ut-robotics/picr22-team-saga/(threads)

Thread 1 (2022-09-19):

[Mechanics] Bring thrower motor lower

maidlam, 2022-09-19:
The thrower motor is able to touch only a slight part of the ball.
Bringing the thrower motor lower by 2 mm (but not more), can improve grabbing ability.

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

Closed 2022-09-24.

Thread 2 (2022-09-19):

[Mechanics] Thrower ramp spacers

maidlam, 2022-09-19:
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

The holes for spacers at position 1 are very close to the planned mounting hole for the side wall.

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

The spacers at position 1 can be removed, and spacers at position 2 can be brought lower, maybe to the midway point between 1 and 2

Add a spacer to the front of the ramps at position 3 for better stability.

Closed 2022-09-24.

Thread 3 (2022-09-19):

[Mechanics] Check direction of thrower motor wires

maidlam, 2022-09-19:
In the current model, it seems like the thrower motor wires will come out into the ramp.
I think the wire hole is in the wrong position in the model.
Verify the actual location of the wires on your physical motor and add a box to represent the wires.

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

georgsnarbuts, 2022-09-21:
I compared this cad model to our actual motor and the wires seem to be located in the same place so i rotated the motor by 180 degrees, so the wires could point outwards. Is this good?

Closed 2022-09-24.

Thread 5 (2022-09-19):

[Mechanics] Move thrower assembly further back

maidlam, 2022-09-19:
Your test robot has a wide front. At the same time the motor is the most forward component in the robot. This can lead to horrible accuracy. The ball can go through the thrower in this motion if it's grabbed from the side.

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

One option to fix this is to move the ramp and thrower motor further back into the robot.
This will give room for the ball to be guided and be centered.
There's some room left behind the thrower, giving the option to do so.

Closed 2022-09-24.

Thread 6 (2022-09-19):

[Mechanics] Make wall mounting holes threaded

maidlam, 2022-09-19:
Currently the mounting holes for the walls are 3 mm unthreaded holes.

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

These should be made as threaded holes. Use the Hole feature to make these.
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

Closed 2022-09-24.

Thread 7 (2022-09-24):

[Mechanics] Thrower assembly too wide

Akustav, 2022-09-24:
The thrower assembly is 0.4mm too wide and tabs clip into the bottom plate:

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

maidlam, 2022-09-30:
Current distance between thrower walls is 50,40 mm.
The top and bottom plate have different distances for the holes for the walls.

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

The holes in the top plate are sketched separately, while the bottom plate uses a pattern to make the holes, that's where the offset might be coming from.

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

Don't know if the holes on the actual robot might have been modified, or the thrower was just jammed in.

Akustav, 2022-10-01:
I think we had one robot that had alignment issues due to a oversight in the review. I think it was milled out like that. I think we modified the thrower tabs to accommodate the thrower. Seems like a small issue, overall.

Closed 2022-10-01.

Thread 8 (2022-09-24):

[Mechanics] motor mount hole joining issue

Akustav, 2022-09-24:
Seems like the motor is joined in a 90 degree offset to how it should be:

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

Closed 2022-09-30.

Thread 10 (2022-10-01):

CM1223 footprint incorrect

ReikoR, 2022-10-01:
SOT143-4 footprint is used:

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

Correct CM1223-**02SO** package is SOT23−5:

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

This is also mentioned on [Components page](https://ut-robotics.github.io/picr22-home/basketball_robot_guide/electronics/components.html#_usb_protection).

AnishShr, 2022-10-03:
Changed the footprint with correct one.

Closed 2022-10-04.

Thread 11 (2022-10-01):

NCP164CSN330T1G does not need feedback resistors

ReikoR, 2022-10-01:
NCP164CSN330T1G has fixed output of 3.3V (V<sub>FIX</sub>).

Feedback resistors can technically be used, but would probably not work if reference voltage is the same or higher compared to output voltage.

From [datasheet](https://www.onsemi.com/pdf/datasheet/ncp164-d.pdf):
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

Closed 2022-10-04.

Thread 12 (2022-10-01):

NCP164 enable pin needs to be connected

ReikoR, 2022-10-01:
I think NCP164 has weak pull-down on enable (EN) pin that disables the regulator when enable pin is left unconnected:

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

Enable pin can be connected to IN pin to enable the regulator.

AnishShr, 2022-10-10:
connected the EN pin to IN.

Closed 2022-10-11.

Thread 13 (2022-10-01):

NCV8730ASN500T1G does not need feedback resistors

ReikoR, 2022-10-01:
NCV8730ASN500T1G has fixed output of 5V.

From [datasheet](https://www.onsemi.com/pdf/datasheet/ncv8730-d.pdf):
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

AnishShr, 2022-10-03:
Feedback resistors removed.

Closed 2022-10-04.

Thread 15 (2022-10-01):

Incorrect encoder connector pinout

ReikoR, 2022-10-01:
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

All existing encoders use this pinout:

1. GND
2. 3.3V
3. ENCA
4. ENCB

Power needs to be connected. Right now it has not been connected.

GND needs to be connected to MCU side. Right now it's connected to motor drivers side (GND2).
Encoders and motors are not electrically connected, only mechanically

AnishShr, 2022-10-03:
Conenctor with correct wire orientation updated.

ReikoR, 2022-10-04:
Avoid placing GND symbols pointing up.
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

GND should point down and positive power symbols should point up. It would be nicer to use power symbols for them not the net labels.
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

Encoder connectors are still connected to GND2. Encoders need to be connected to MCU GND.

AnishShr, 2022-10-10:
changed the symbol orientations accordingly.

Closed 2022-10-11.

Thread 16 (2022-10-01):

Incorrect thrower ESC signal connector pinout

ReikoR, 2022-10-01:
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

Current ESC connectors have this pinout:

1. GND
2. PWM
3. Not connected
4. Not connected

AnishShr, 2022-10-03:
Connector with correct wire orientation updated.

Thread 17 (2022-10-01):

nFAULT LEDs not connected correctly

ReikoR, 2022-10-01:
DRV8243 nFAULT pins are open drain outputs.

For LEDs to work, they need be connected to logic voltage (5V in this case).

More information:
https://ut-robotics.github.io/picr22-home/basketball_robot_guide/electronics/schematic.html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

AnishShr, 2022-10-03:
LEDs removed from the nFAULT lines.

ReikoR, 2022-10-04:
LEDs can still be used, but have to be connected differently.

Closed 2022-10-04.

Thread 18 (2022-10-01):

PDRV8243HRXYQ1 does not have SPI

ReikoR, 2022-10-01:
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

DRV8243 drivers we have are the HW variant in VQFN-HR (14) package.

AnishShr, 2022-10-03:
Symbol and footprint with VQFN-HR(14) variant updated

ReikoR, 2022-10-04:
All configuration pins cannot be left unconnected.
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

**IPROPI** pin needs a resistor to set the output current limit. I recommend configuring current limit to around 2 - 3A to help prevent motor from overheating.
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

**DRVOFF** need to be connected to ground, otherwise the outputs will be disabled. DRVOFF has internal pullup.
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

**DIAG** pin I would recommend connecting to GND to allow the driver to enable the outputs again after a small off period (t<sub>off</sub>). This allows for higher motor power, but it might be ok without it also.
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

**MODE** pin needs to be connected to set the driver to PH/EN (PWM/direction) mode.
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

I added older datasheet that contains pre-production driver information to the components page:
https://ut-robotics.github.io/picr22-home/basketball_robot_guide/electronics/components.html#_motor_driver

AnishShr, 2022-10-06:
According to the datasheet:
For the VQFN-HR package, AIPROPI = 3070 A/A
We are operating the HW variant in RLVL6of6 for ITRIP, SR, and DIAG, meaning not connecting those pins.
For this config, VITRIP = 2.97 V
For this configuration:
ITRIP Regulation = VITRIP / RITRIP * AIPROPI
This yields RITRIP approximately to 3040 Ohms. What will be the closest resistance we have in the 0603 package to this resistance?

ReikoR, 2022-10-08:
You might have already checked yourself, but in the lab we have 3k and also 2.7k and 3.3k 0603 resistors.

AnishShr, 2022-10-10:
Connected all other pins as instructed in the datasheet.

Closed 2022-10-11.

Thread 19 (2022-10-01):

DRV8243 VM pins need more capacitance

ReikoR, 2022-10-01:
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

More capacitance is needed during switching at driver's input (VM) to avoid voltage drop at the driver's output.
Around 50 uF or more might be fine. For example it's possible to use 5x 10 uF ceramic capacitors.

AnishShr, 2022-10-03:
50uF capacitance put across the driver's output

ReikoR, 2022-10-04:
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

50uF 0603 capacitors do not exist.

For example 47uF 25V capacitors are much bigger and expensive:
https://www.mouser.ee/c/passive-components/capacitors/mlccs/multilayer-ceramic-capacitors-mlcc-smd-smt/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

Using 5x 10 uF 1206 25V+ capacitors or similar is better option.

Typical recommendation is to use capacitors with voltage rating at least twice the maximum working voltage. For 16.8V batteries it the closest voltage rating is 35V, but 25V should also be ok in this case. Ceramic capacitor capacitance decreases with voltage.

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
https://www.murata.com/en-us/support/faqs/capacitor/ceramiccapacitor/char/0005

AnishShr, 2022-10-10:
changed the 50uF capacitor with a parallel combination of 5 10uF capacitors (5 X10uF = 50uF)

ReikoR, 2022-10-11:
10uF capacitance is bit too big for 0603 capacitors. 0603 10uF capacitors are not that common and cost more. In the lab we have 1206 capacitors. We can also order 0805 capacitors which cost about the same as 1206 ones.

You should change 10uF capacitors to either 1206 or 0805 package.

AnishShr, 2022-10-11:
changed the 10uF capacitors to 0805 package

Closed 2022-10-12.

Thread 20 (2022-10-01):

Keep isolated sides completely separate

ReikoR, 2022-10-01:
There needs to be clear separation between isolated sides, that splits the board in two.

Illustrative image with some modifications. Taken from [this guide](https://www.ti.com/lit/an/slla284f/slla284f.pdf?ts=1664620687565):

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

ReikoR, 2022-10-03:
Yes, there should not be any copper.

AnishShr, 2022-10-10:
Isolator's sides to be isolated are completely isolated (Not even copper pour in between)

ReikoR, 2022-10-11:
Grounds should not extend past the isolators.

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

AnishShr, 2022-10-11:
GND and GND2 filled on both inner layers with ground not extending past the isolators

Closed 2022-10-12.

Thread 22 (2022-10-01):

Mounting holes are too close to the edge

ReikoR, 2022-10-01:
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

AnishShr, 2022-10-03:
Mounting holes shifted a little inside.

ReikoR, 2022-10-05:
Holes are still probably too close to the edges:
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

Also Typical M3 bolt head has a diameter of about 5.5mm. There should not be any tracks or components near the mounting holes that might be damaged by the bolt head:
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

AnishShr, 2022-10-10:
Mounting hole's external diameter is set to 6mm, and the hole to 3mm.

Closed 2022-10-11.

Thread 23 (2022-10-01):

Add reverse voltage protection MOSFET to motor drivers power input

ReikoR, 2022-10-01:
More info:
https://ut-robotics.github.io/picr22-home/basketball_robot_guide/electronics/components.html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

ReikoR, 2022-10-04:
Yes, they are connected.

AnishShr, 2022-10-10:
Added the reverse voltage protection MOSFET to Motor driver's input pin.

ReikoR, 2022-10-11:
1. There is no need for multiple MOSFETs, 1 is enough.
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

2. I don't think that 1N53xxB diodes exist in 0603 package. You need to select a diode that we have in the lab (not sure if and what we have) or that can be ordered. For BUK6Y10 you probably won't need the diode, because the gate-source voltage rating is 20V, which is higher than the battery voltage.
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

3. You definitely should not have 10-ohm resistor across battery voltage.
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

In the [guide](https://components101.com/articles/design-guide-pmos-mosfet-for-reverse-voltage-polarity-protection) they are used a a load. For the mainboard the load is the motors.
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

AnishShr, 2022-10-11:
changed the connections as instructed with just one MOSFET

Closed 2022-10-12.

Thread 24 (2022-10-01):

Use as wide as possible connections for high currents

ReikoR, 2022-10-01:
Motor driver outputs and power supply should use wider connections.

Based on Saturn PCB Toolkit a 0.4 mm wide track can carry 2.3A at 20 degree temperature rise:

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

Motor drivers might output more current and power supply traces need to carry 3 times of that if drivers are connected in series.
I recommend having wide and short copper zones for high currents.

AnishShr, 2022-10-03:
Motor driver's output with track width 0.5mm updated.

ReikoR, 2022-10-05:
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

It would be better if connections were shorter and wider.
Current pin headers are not a very good choice for connecting motor outputs. It would be better to create component with a SMD pad footprint large enough to allow wires to be soldered to it.

For example something like this:
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

Small vias can be placed inside drivers pads for the shortest connections to power. Capacitors can be placed on the other side of the board below drivers.
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

AnishShr, 2022-10-10:
Track width for the motor driver's output lines have been set to the width of the motor driver's ouptut pad width.

AnishShr, 2022-10-11:
changed the connectors making the connections short

ReikoR, 2022-10-12:
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

High current connections need to be wider.

Use copper zones and multiple small vias (0.2/0.45mm is the recommended smallest size by JLCPCB).

Rough example:
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

Driver outputs and V+ should also be connected with wide copper fills.

AnishShr, 2022-10-13:
High current paths all connected with copper fills

ReikoR, 2022-10-15:
1. Use solid pad connection for high currents:
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

2. Use multiple small vias instead of one larger via. Multiple small vias have smaller total inductance, higher current carrying capability and don't pull away the solder that easily when placed inside a pad.
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

3. Drill diameter for small vias should be 0.2mm, otherwise the annual ring will be too narrow.
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

4. Use larger pads for high currents. Current pads might be too small to solder wires to. Larger pads also are more robust. Smaller pads might break off the board. Putting multiple vias inside the pad would also help to make it mechanically more robust.
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

AnishShr, 2022-10-20:
All power lines routed through copper fills

ReikoR, 2022-10-23:
1. Reverse voltage protection MOSFET could be rotated to make VM polygon wider.
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
\
It would be even better if battery input (V+) pad could be placed on top of the MOSFET.
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

2. Motor driver VM capacitor could be better aligned with the driver pads.
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

3. There is no need to place vias inside pads for motor driver configuration pins. This will make soldering harder.
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
\
Something like this should be enough:
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

AnishShr, 2022-10-23:
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

How can we get rid of this issue? The copper fill clearance is set to 0.25 mm, but the fill has a clearance of 0.1016mm only in one of the edges.

ReikoR, 2022-10-23:
You should use different priority levels for adjacent zones. Then the zones are filled in an order and clearance between them is automatically kept.
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

AnishShr, 2022-10-23:
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
Is this warning fired because 'VM' is present in only one layer?

ReikoR, 2022-10-23:
Yes

AnishShr, 2022-10-23:
So shall I copper fill on the other layer as well? Or what shall I do?

ReikoR, 2022-10-23:
Just remove those vias, since they are not connecting to anything on other layers.

AnishShr, 2022-10-23:
These vias also include the ones in the decoupling capacitors. Should I remove them as well?

ReikoR, 2022-10-23:
If you mean the ones connected to MCU VDDA, then yes.

AnishShr, 2022-10-23:
unnecessary vias removed and power routed via copper fills and usage of multiple small vias where necessary

AnishShr, 2022-10-26:
Most part of the nSleep trace routed in front copper making wise copper fills for VM

ReikoR, 2022-10-26:
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

Rotating the reverse voltage protection MOSFET would help to improve current paths:
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

AnishShr, 2022-10-26:
MOSFET rotated and shifted to provide better current distribution path as instructed.

ReikoR, 2022-10-27:
MOSFET should not moved too much to the center of the board. Having signal traces close to each other will cause more noise on them.

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

AnishShr, 2022-10-27:
MOSFET moved away from other traces

ReikoR, 2022-10-29:
You should also route tracks straighter and with more spacing between them. Noise on a trace from an adjacent trace is bigger when tracer are closer to each other or are close for longer. Running traces parallel next to each other should be minimised.
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

AnishShr, 2022-10-30:
Spacing between traces increased

Closed 2022-10-31.

Thread 25 (2022-10-01):

Prefer 0603 passive components

ReikoR, 2022-10-01:
Most of the passive components available in the lab are in 0603 package.
If you don't want or need to save board space, then it would be better to use 0603 for most of the passive components.

AnishShr, 2022-10-03:
All passive component's footprint updated to 0603 package.

AnishShr, 2022-10-10:
All passive components changed to the 0603 package

AnishShr, 2022-10-11:
apart from 10uF capacitors, all other passive device changed to 0603 package

Closed 2022-10-12.

Thread 26 (2022-10-01):

Use switching regulator instead of linear regulator for servo power

ReikoR, 2022-10-01:
Linear regulators are too inefficient for higher currents.

We have these components available in the lab:

- XTPS62933DRLR (TPS62933 buck converter)
- SRP6060FA-5R6M (Inductor 5.6uH 10A)

You can use TI WEBENCH to get recommended designs for TI components:
https://webench.ti.com/power-designer/switching-regulator

ReikoR, 2022-10-05:
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
1. On the schematic you have TPS62932, not TPS62933.

2. Pinout is incorrect. Correct pinout from datasheet:
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

3. Power inductor needs to connected to SW pin, not a ferrite bead. We have SRP6060FA-5R6M inductors, which are suitable.
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

4. Switching regulator and all other components connected to the motors power should be on the other side of the isolators. PCB needs to be clearly divided into two isolated sides.
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

AnishShr, 2022-10-10:
The footprint for ferritebead changed to indcutor. And the isolators have been placed between two different power sources, dividing the PCB into two parts in regard to the power source.

ReikoR, 2022-10-11:
1. Bootstrap capacitor needs to be connected between BST and SW pins. SW pin needs to be connected to inductor.
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

2. Feedback resistors need to connect to FB pin.
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

AnishShr, 2022-10-11:
changed the connections for the BUK6Y10. Removed the diode and 10 ohm resistors, with feedback resistors connected to FB pin, and bootstrap capacitor between SW and BST pin

ReikoR, 2022-10-15:
1. Inductance is still incorrect.
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

2. Try to follow layout guidelines in the [TPS62933 datasheet](https://www.ti.com/lit/ds/symlink/tps62933.pdf).

For example:
> Place the inductor, input and output capacitors, and the IC on the same layer.

Currently regulator and inductor are on the top layer and capacitors on the bottom layer.
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

> Place the input and output capacitors as close as possible to the IC.

Output capacitor is far away.
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

> The VIN and GND traces must be as wide as possible and provide sufficient vias on them to minimize trace impedance. The wide areas are also of advantage from the view point of heat dissipation.
Keep the SW trace as physically short and wide as practical to minimize radiated emissions.

Current traces/connections are narrow and could probably be shorter. Use multiple small vias (0.2/0.45) for VIN, GND, +5VD for lower inductance. In general multiple smaller vias work better than one larger via for reducing inductance and having higher current carrying capability.

3. It would also be better to have servo connector near the regulator output.
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

4.  In regards of more general layout, having isolators on the top layer and switching regulator components on the bottom side might improve the layout. Right now every signals needs a via on both sides of the isolators.
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

AnishShr, 2022-10-20:
Inductor connection updated, with input/output capacitors placed close.

Also, the power lines are routed through copper fills, each pad with multiple small vias.

ReikoR, 2022-10-23:
1. Inductance value is still incorrect.
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

2. From [datasheet](https://www.ti.com/lit/ds/symlink/tps62933.pdf):
> Place the feedback divider as close as possible to the FB pin. A > 10-mil width trace is recommended for heat dissipation. Connect a separate VOUT trace to the upper feedback resistor. Place the voltage feedback loop away from the high-voltage switching trace. The voltage feedback loop preferably has ground shield.

It's better to have separate 5V feedback trace that is shielded with ground vias. Running it on opposite layer (top in this case) should help to shield it more.
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

3. All the vias marked with a yellow arrow do not connect to any other layers and should be removed:
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

4. There is only 1 ground via:
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
\
Something like this would be better:
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
I rotated and moved the capacitors a bit and added copper fill on bottom layer and multiple ground vias.

AnishShr, 2022-10-23:
8.8 uH Inductor placed with power routed through copper fills and use of vias

ReikoR, 2022-10-25:
1. SRP6060FA-5R6M is a 5.6uH inductor, not 6.8uH.
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

2. 5V feedback trace is quite close to driver signal traces.
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
\
It would be better to increase distance between traces and add ground vias for shielding:
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

3. 5V feedback should only be connected with trace on top layer and not with copper fill on bottom layer:
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

4.  FB trace is very close to the inductor.
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
\
Try to follow layout recommendations in the datasheet:
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
\
Something like this might be better:
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

AnishShr, 2022-10-26:
Changed the layout and added GND vias across one side of the 5V trace.

Closed 2022-10-26.

Thread 9 (2022-10-01):

Pull-up resistor on USB D+ line is not needed

ReikoR, 2022-10-01:
SMT32G441 has embedded pull-up resistor.

From [datasheet](https://www.st.com/resource/en/datasheet/stm32g441kb.pdf):
> **3.35 Universal serial bus (USB)**
> ... The internal USB PHY supports USB FS signaling, embedded DP pull-up and ...

More information is available under **45 Universal serial bus full-speed device interface (USB)** in [reference manual](https://www.st.com/resource/en/reference_manual/rm0440-stm32g4-series-advanced-armbased-32bit-mcus-stmicroelectronics.pdf).

AnishShr, 2022-10-03:
The pull up resistor has been removed. Pushed new design in the github repository: https://github.com/ut-robotics/picr22-team-saga/tree/electronics

Thread 27 (2022-10-05):

[Mechanics] Change Spacing in Arrange

maidlam, 2022-10-05:
Change the Spacing setting in the Arrange feature for the Manufacturing Model.
The 6 mm value in Object Spacing causes the tool to jump between parts to mill them out (6 mm gap, 3 mm wide tool, Fusion wants to keep the part attached to the stock material until the very end).
Use these settings below.

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

Closed 2022-10-06.

Thread 28 (2022-10-05):

[Mechanics] Move Pocket operation before Contours

maidlam, 2022-10-05:
After milling out a piece, depending on factors, there is a chance that the piece can move/ become loose, the pocket might not end up at the desired place.
See also: https://ut-robotics.github.io/picr22-home/basketball_robot_guide/mechanics/cam.html#_order_of_operation

Move the pocket operation above the Contours, so it will be done before the Contours.

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

Closed 2022-10-06.

Thread 29 (2022-10-05):

[Mechanics] Change Stock to Leave for Pocket

maidlam, 2022-10-05:
Change the Stock to Leave values of the Pocket operation.
Current settings don't cut the material at all.

Use the settings from the guide:
https://ut-robotics.github.io/picr22-home/basketball_robot_guide/mechanics/cam.html#_pocket

Closed 2022-10-06.

Thread 30 (2022-10-12):

Place ESD protection as close as possible to USB connector

ReikoR, 2022-10-12:
TVS diodes (diode arrays) should be placed as close as possible to connectors to prevent ESD from reaching to any of the components.

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

AnishShr, 2022-10-13:
ESD protection placed close to the USB

ReikoR, 2022-10-23:
ESD protection could be even closer, but it might be good enough.
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

Closed 2022-10-23.

Thread 31 (2022-10-12):

Fix DRC errors (and warnings if possible)

ReikoR, 2022-10-12:
Use **Inspect -> Design Rule Checker**

Unconnected nets are the probably the biggest problem:
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

Unconnected nets can also be seen without running DRC.
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

AnishShr, 2022-10-13:
DRC errors fixed, except few(Not an error actually)

Please have a look

ReikoR, 2022-10-15:
There is a clear unconned +3.3V net:
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

AnishShr, 2022-10-15:
The unconnected 3.3V nets both are connected to two 3.3V pins of the microcontroller, which are internally connected. Is it necessary to connect them externally?

ReikoR, 2022-10-16:
Power should never be routed through components. Component might not have enough current carrying capability and all the noises add together if current paths are shared between components. Ideally power should be routed from single point (power source) to each component through separate (straight) path.

It would probably be better to change bottom layer copper fill from GND to +3.3V and route most of the signals on top layer to reduce gaps in the +3.3V copper. There already are 2 GND copper fills on internal layers.

ReikoR, 2022-10-23:
There are still a lot of errors that can be fixed.

AnishShr, 2022-10-23:
DRC errors fixed (Few warnings left: especially for mounting holes vias)

Closed 2022-10-26.

Thread 32 (2022-10-15):

Improve USB signal routing

ReikoR, 2022-10-15:
Current routing:
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

1. USB data signals are a 90-ohm differential pair and should be routed on the PCB to match that.
2. Using vias should be avoided for differential pairs or if not possible, should be kept symmetric in both signals in a pair, so that same amount of vias is used and at the same locations in both signal traces.
3. Traces should also be as symmetric and straight as possible.
4. Differential signal routing should usually prioritised over routing other (single-ended) signals and power.

JLCPCB has [impedance calculator](https://cart.jlcpcb.com/impedanceCalculation) for their stackups.
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

We'll use JLC3313 stackup, because it has smaller gap between layers, which helps to improve signal integrity because electric fields (between signal and reference [usually GND] layer) of different signals interact less with each other, since electric fields don't spread out as much.

8 mil gap and 6.03 mil trace widths are close enough to 2mm and 1.5mm, so those can be used.

Differential pair (DP) width and gap can be specified in the Board Setup.
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

Some board constraints should also be adjusted.
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

Default shortcut for differential pair routing is 6.
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

AnishShr, 2022-10-16:
Should the differential pair be symmetric for connections to the ESD protection as well, or is it ok if the differential pair routing is symmetric only from the microcontroller pins to the SUB?

ReikoR, 2022-10-16:
Ideally differential pair should be symmetric everywhere. ESD protection should be aligned so that the signals can be routed underneath the ESD protection component.

Example layout of ESD protection component with same pinout as CM1223-02SO:
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

Image taken from here:
https://www.we-online.com/catalog/media/o109030v410%20AppNotes_ANP002_TheProtectionOfUSB20Applications_EN.pdf

AnishShr, 2022-10-20:
Differential pair routed

ReikoR, 2022-10-23:
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

USB differential signals can be more straight and symmetric.

KiCad differential pair routing does not work very well, so some manual routing and moving of tracks is probably needed.

Improved result can look something like this:
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

AnishShr, 2022-10-23:
Differential pair for USB routed appropriately (please check)

ReikoR, 2022-10-25:
1. USB signal traces do not have correct width:
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

2. I'm not sure if there are manufacturing issues with it, but it's probably good idea to avoid sharp (internal) corners:
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
\
Connect straight to pads if possible:
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
\
Or move traces slightly away from the pads:
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

AnishShr, 2022-10-26:
Traces palces straight to the USB pads in uC.

ReikoR, 2022-10-26:
USB signal trace width is still incorrect.

AnishShr, 2022-10-26:
USB signal trace changed to 0.153 mm

ReikoR, 2022-10-27:
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

Spacing between traces needs to be 0.2mm (not 0.25mm) to have correct differential impedance.

AnishShr, 2022-10-27:
spacing between the USB differential traces maintained to 0.2 mm

Closed 2022-10-29.

Thread 33 (2022-10-15):

Place decoupling capacitors as close as possible to power pins

ReikoR, 2022-10-15:
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

ReikoR, 2022-10-23:
MCU decoupling capacitors are incorrectly placed or can be closer to MCU pins:
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

AnishShr, 2022-10-23:
Decoupling capacitors placed closer and in correct place

ReikoR, 2022-10-25:
1. Each power pin should have one 100nF capacitor close to it:
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

2. Decoupling capacitors should be connected on the same layer with wide traces. Connecting them through bottom layer with vias will have worse inductance which decreases the usefulness of the capacitors.
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

AnishShr, 2022-10-26:
All decoupling capacitors connected with wide traces in same layer

ReikoR, 2022-10-26:
1 uF capacitor on the schematic is meant for analog supply filtering:
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

AnishShr, 2022-10-26:
1 uF capacitor placed in appropriate position.

Closed 2022-10-27.

Thread 34 (2022-10-23):

Unnecessary vias

ReikoR, 2022-10-23:
1. There are a lot of vias connected only on 1 layer. This can also be checked with DRC.
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

2. You don't need that many vias for low currents. Up to 2 per decoupling capacitor is enough. Adding to many vias inside pads can make soldering hard.
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
\
Something like this would be good for most decoupling capacitors:
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
Keeping +3.3V and GND vias close to each other makes sure that electric field between them spread out less.

3. Programmer connector does not have any high currents. 1 via per pin is enough.
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

AnishShr, 2022-10-23:
Unnecessary vias removed

AnishShr, 2022-10-23:
Can we put just one via in the Isolators pins and decoupling capacitors?

ReikoR, 2022-10-26:
1. Another thing to avoid are wide gaps in copper fills created by vias that are close to each other:
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
\
More space should be added between vias:
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

2. Use same small size via everywhere on the board:
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

AnishShr, 2022-10-26:
Uniform via size maintained all over the PCB with gaps maintained as well.

Closed 2022-10-27.

Thread 35 (2022-10-26):

Incorrect servo pinout

ReikoR, 2022-10-26:
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

Correct pinout is:
1. GND
2. 5V
3. PWM

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
https://dronebotworkshop.com/servo-motors-with-arduino/

AnishShr, 2022-10-26:
Connector for servo motor in correct pinout orientation updated

Closed 2022-10-27.

Thread 36 (2022-10-26):

Silkscreen text too small

ReikoR, 2022-10-26:
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

JLCPCB recommended minimums are here (under Legend section):
https://jlcpcb.com/capabilities/pcb-capabilities

> Minimum Line Width: 0.153mm
> Minimum text height: 1.0mm

AnishShr, 2022-10-27:
Silkscreen text updated: Text Height=1.0mm; Text Width=1.0mm; Text Thickness = 0.2mm

Closed 2022-10-27.

Thread 37 (2022-10-27):

Connect 3.3V regulator output capacitor directly

ReikoR, 2022-10-27:
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

Same as with decoupling capacitors, it's better to have direct connection on the same layer.

AnishShr, 2022-10-27:
3.3V regulator output capacitor connected directly in same layer

Closed 2022-10-29.

Thread 38 (2022-10-27):

Silkscreen improvements

ReikoR, 2022-10-27:
1. Avoid placing reference designators under components. They should be visible when components are on the board.
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

2. Try to use same rotation for adjacent text/reference designator for easier readability.
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

3. For driver output pads and power input pads it would be more useful to remove/hide reference designators and use custom text that is more descriptive.
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
\
Similar to connectors.
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

AnishShr, 2022-10-27:
Labels for components oriented in same direction and outside the component space.

For Motor driver output pads: OUT+ and OUT- Labels are placed for each driver outputs.
For Servo pins, labels: Signal->S, 5V->+, GND->- have been placed
For Battery inputs, Battery+->BAT+, Battery- -> BAT- have been placed
For Thrower Power Output pads, Thrower+ -> THRWR+, Thrower- -> THRWR- have been placed

AnishShr, 2022-10-28:
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

Labels renamed something like this

Closed 2022-10-29.

Thread 39 (2022-10-27):

Routing improvements

ReikoR, 2022-10-27:
1. Rotating servo connector would improve routing.
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
\
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

2. Thrower and servo signals could be swapped to get rid of 2 vias in servo signal.
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

ReikoR, 2022-10-29:
On the MCU side, try to route mostly on top layer, so that there is more room for (3.3V) current to flow. Right now current (indicated with yellow lines) has to go through narrow gaps or around traces.
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

AnishShr, 2022-10-30:
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

Is this much routing in the back copper considerable?

AnishShr, 2022-10-30:
New design with minimal routing (as minimum as possible) in back copper layer in the uC side updated.

ReikoR, 2022-10-31:
New routing is better.

Closed 2022-10-31.

Thread 40 (2022-10-31):

Mounting hole and board outline coordinates

ReikoR, 2022-10-31:
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

It would be easier to add mounting holes in robot's mechanical design if PCB mounting holes were on a 1mm or 0.5mm grid.

Board outline (Edge Cuts rectangle) also has weird dimensions:
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

AnishShr, 2022-10-31:
board cutouts and mounting holes aligned in a 0.5mm grid size with proper dimensions.

Closed 2022-11-01.

Thread 41 (2022-10-31):

Create Gerber X2 files

ReikoR, 2022-10-31:
Create Gerber X2 layer and drill files and commit them to repository for ordering the manufacturing.

AnishShr, 2022-10-31:
Gerber files with drill files generated.

ReikoR, 2022-11-01:
PCBs have been ordered.

Closed 2022-11-01.

Thread 42 (2022-11-21):

[Mechanics] Use countersunk bolts instead of bolts and nuts

maidlam, 2022-11-21:
Since you're 3D printing the wheel, you can use countersunk screws that attach the fastener to the wheel.
The bolts will attach to threads in the fastener.

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

Closed 2022-12-04.

Thread 43 (2022-11-21):

[Mechanics] Make fastener lower

maidlam, 2022-11-21:
This is related to issue #42.

Removing the bolts will give you room to bring the mounting bolt point closer to the wheel and let you make the fastener lower.

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

Closed 2022-12-04.

Thread 44 (2022-11-21):

[Mechanics] Add hole inside wheel

maidlam, 2022-11-21:
Add a hole inside the wheel that the motor shaft can go into.
Although in the current model, the motor shaft doesn't interfere with the wheels, it adds more adjustability for future cases.

Closed 2022-12-04.

Thread 47 (2022-12-04):

Switch hole spec not up to spec

Akustav, 2022-12-04:
Refer here for what the switch holes need to be: https://ut-robotics.github.io/picr22-home/basketball_robot_guide/mechanics/design.html#_switches

Akustav, 2022-12-07:
FYI this switch might be difficult to use. Technically you need only one switch for the main motors.

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

Thread 51 (2022-12-04):

Overcomplicated camera mount

Akustav, 2022-12-04:
Why have such angle and location adjustability? You can look from behind the robot to the ceiling. Is this needed?

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

Additionally the camera location slot might not have any use. The camera s RGB sensor is currently not centered with the robot. If you try to move it with your current design, it is impossible because the camera leg is in the way:

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

You most likely want the location from the front be like this:
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
And the camera should point like this:
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

Closed 2022-12-07.

Thread 52 (2022-12-04):

Thrower motor cable in line of fire

Akustav, 2022-12-04:
The motor cable can be damaged when hitting something or someone hitting you since it is right in front of the robot and not guarded by anything.

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

Closed 2022-12-07.

Thread 53 (2022-12-04):

Bad way to create assemblies

Akustav, 2022-12-04:
Currently you have almost every component separately in the main assembly. It should be created of sub-assemblies, like the motor module, camera module, chassis, thrower and so on. This helps with the readability of this file

Closed 2022-12-07.

Thread 56 (2022-12-09):

CAM - Operations issues

maidlam, 2022-12-09:
2D Contour 2:

- Geometry > Disable Rest Machining
- Linking > Linking > Disable Keep Tool Down, this causes unwanted cuts when moving between contours

Pocket:

- Passes > Enable Multiple Depths, set Maximum Roughing Stepdown to 1 mm
- Passes > Enable Stock to Leave, set Radial to -0,05 mm, set Axial to 0 mm

Both Drilling operations:

- Heights > Top Height, set From to "Stock top"

Thread 60 (2023-01-14):

Mainboard documentation

ReikoR, 2023-01-14:
1. _"There is a SUB connector in the board"_
\
SUB -> USB

2. Specify what type and how many motors the board can control and what is the input voltage and output current limits.

3. Programmer pinout is incorrect.
\
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

4. Thrower connector has 4 pins.
\
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

5. Add reference designators to connector pinouts.

6. Typos/misspellings:
    - regualtor
    - motros
    - sneds
    - Conenctors

AnishShr, 2023-01-14:
Errors corrected.

ReikoR, 2023-01-15:
1. _"The board can controlcontrol 3 DC motors."_
\
controlcontrol -> control
\
Specify which type of DC motors. Brushed or brushless.

2. The output current of the Voltage regulator is about 2.77 A.
\
Do you mean motor driver, instead of voltage regulator?
Also 2.77A is not correct if 3k IPROPI resistor is used.

3. All encoder connector pinouts are written as Motor1.
\
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
\
Encoder connector pinouts can be grouped together, since the pinouts are the same.

4. README.asciidoc needs to be in `electronics` directory as is written here:
https://ut-robotics.github.io/picr22-home/team_documentation_requirements.html

AnishShr, 2023-01-15:
3.3k resistor is sued in IPROPI pin, so the output is around 2.77 A. This is explained in the updated file.

AnishShr, 2023-01-16:
All changes made as requested and pushed to repo.

Closed 2023-01-18.
