ut-robotics/picr22-team-saga/electronics/Schematic PDF/schematic.pdf

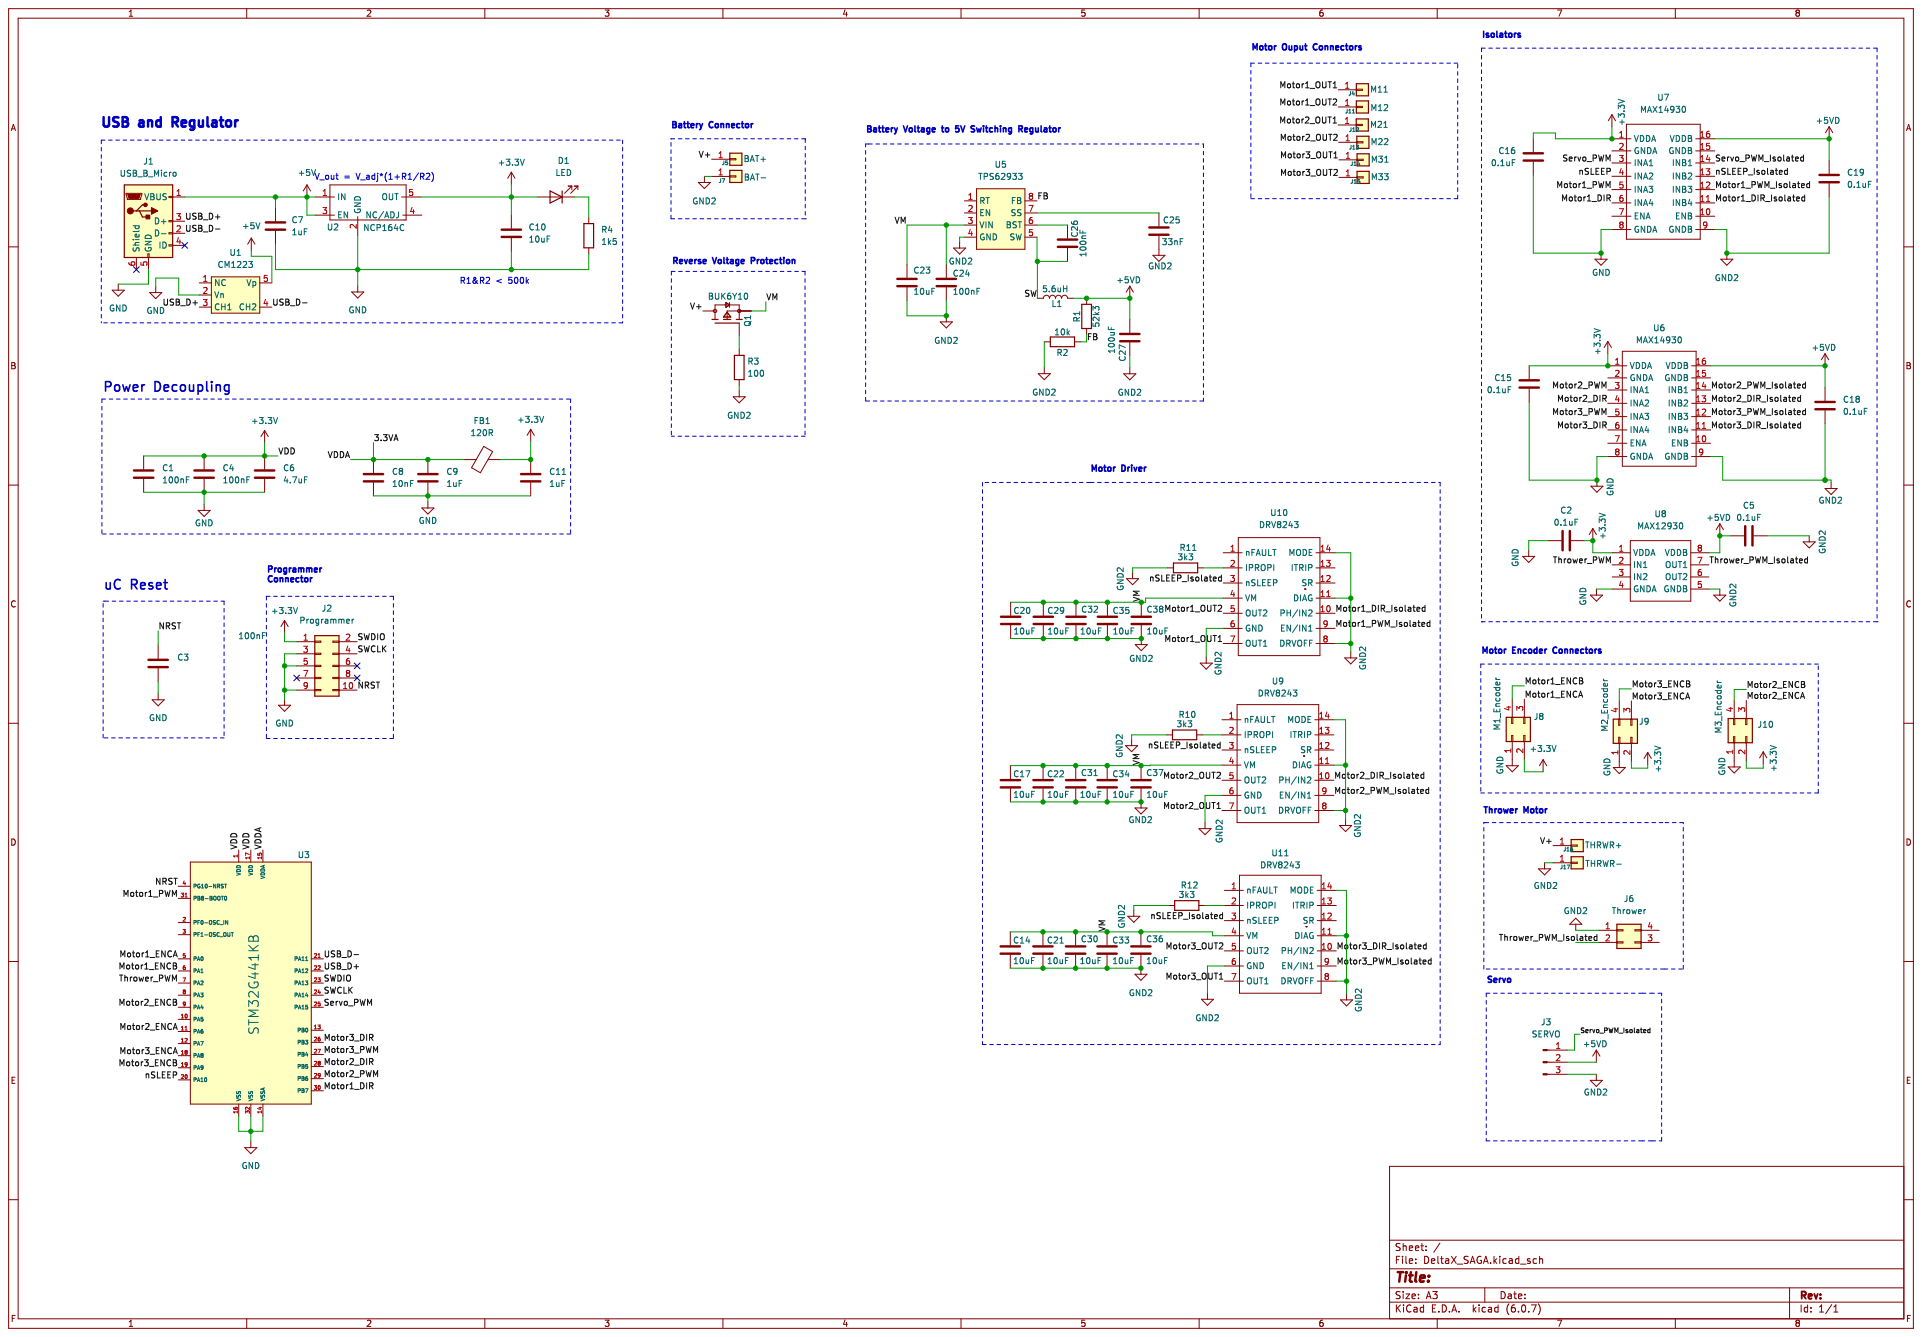
[picture p3: page 1]
