ut-robotics/picr22-team-saga/electronics/screenshots/Schematic_revised(1).pdf

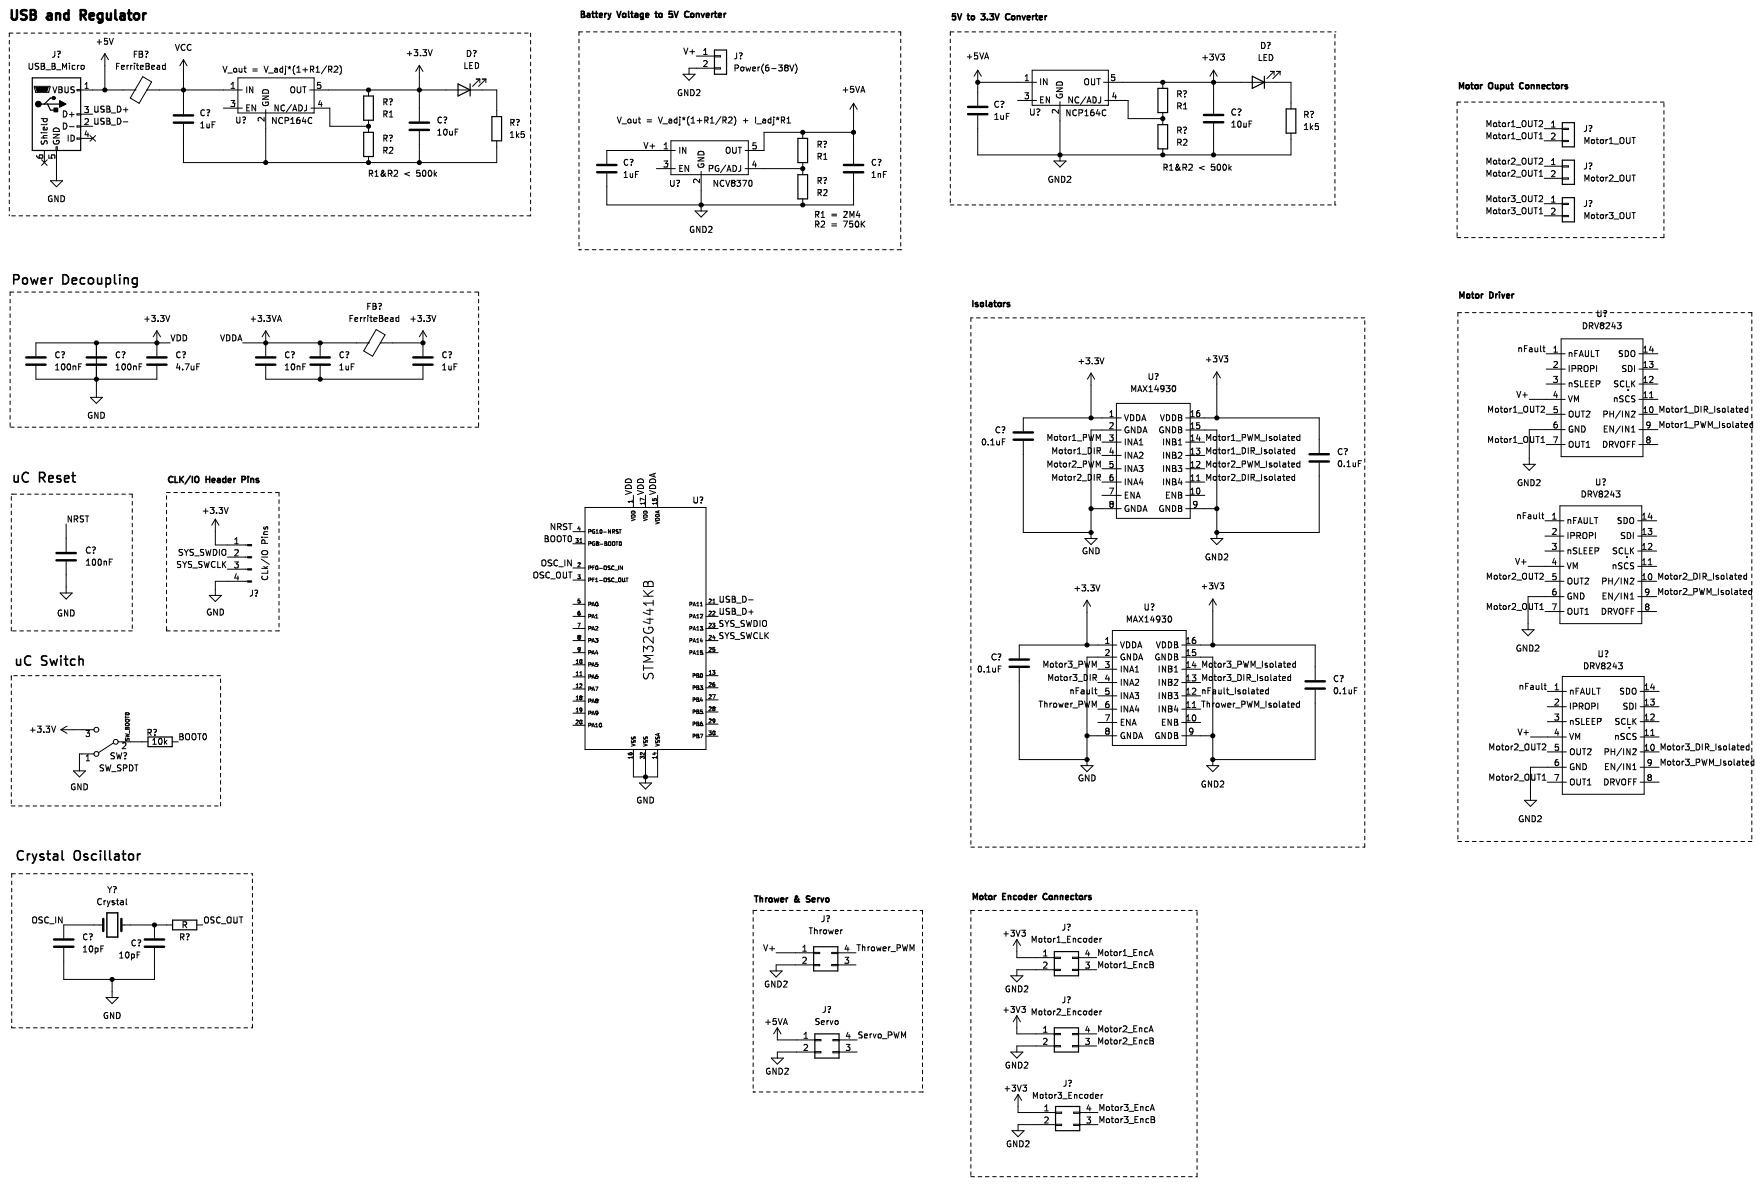
[picture p4: page 1]
