ut-robotics/picr22-team-saga/electronics/screenshots/Schematic.pdf

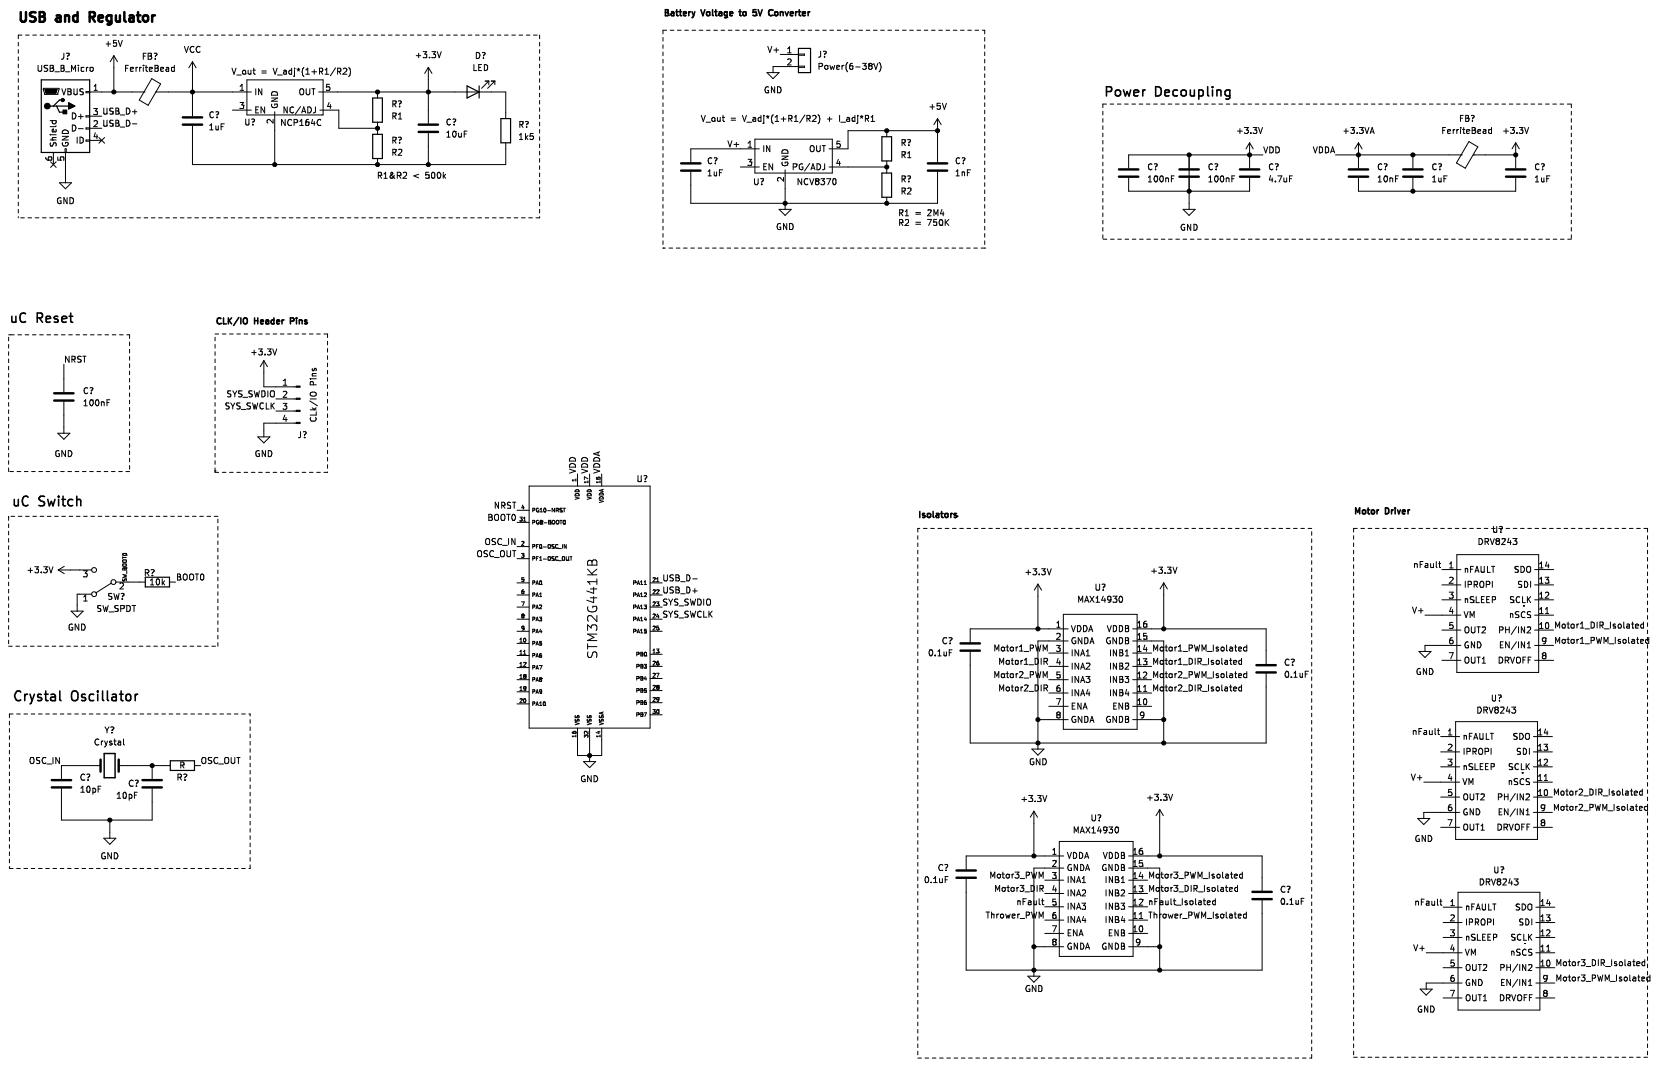
[picture p5: page 1]
