ut-robotics/picr22-team-saga/electronics/DeltaX_SAGA/DeltaX_SAGA.kicad_pcb

## KiCad design electronics/DeltaX_SAGA/DeltaX_SAGA.kicad_pcb (2022-11-14)

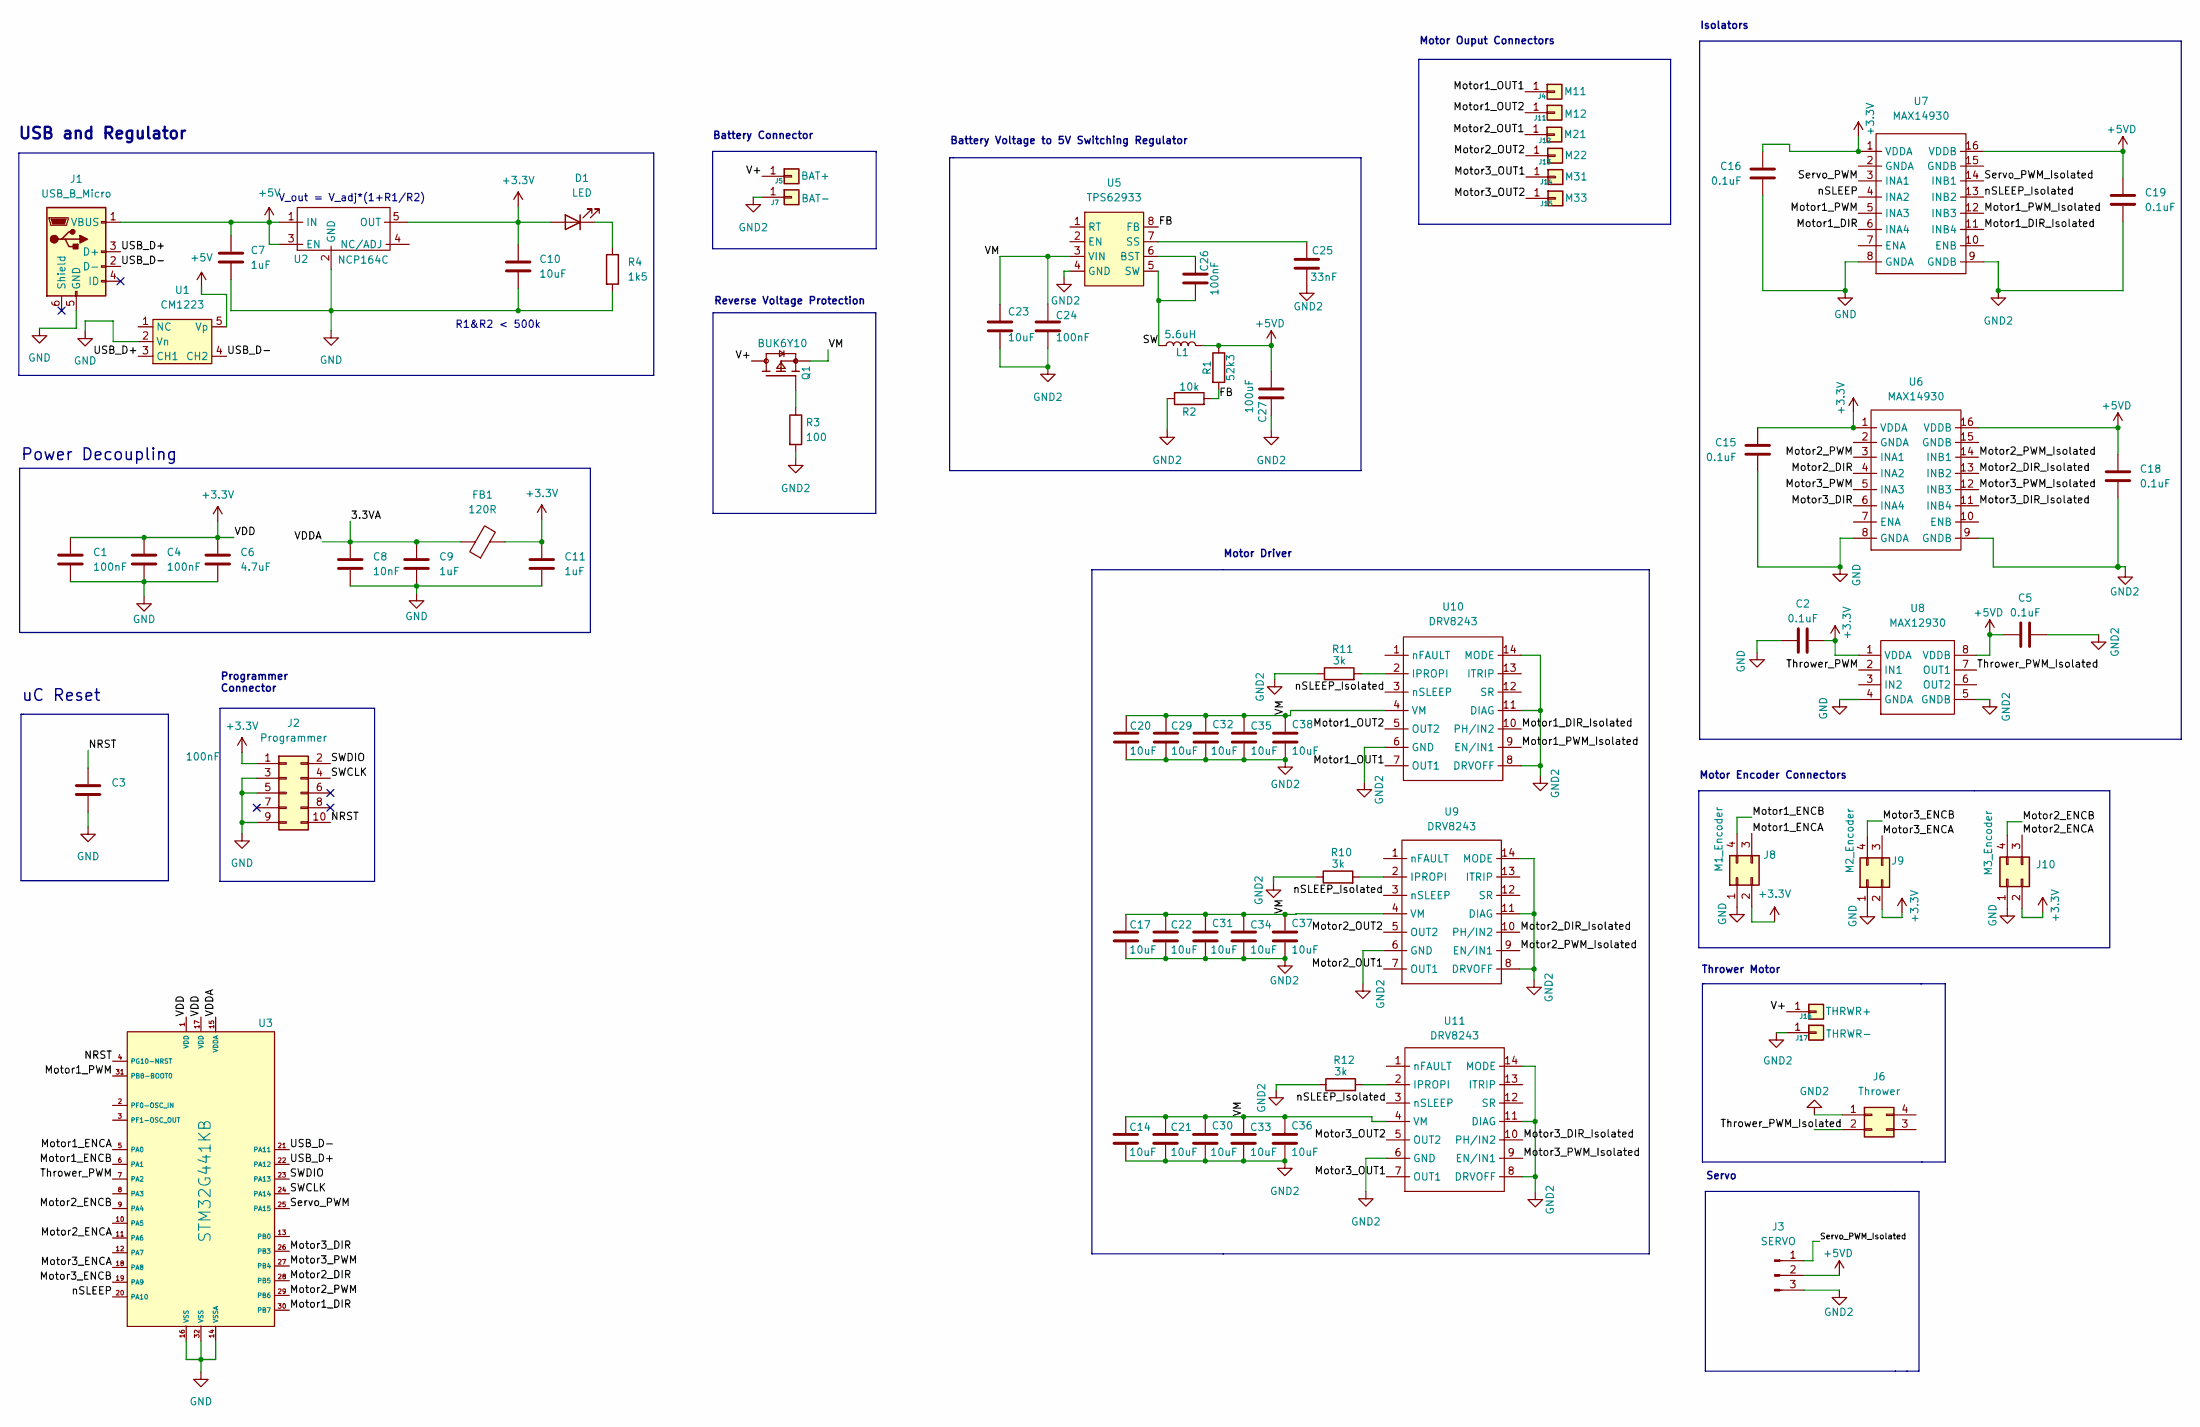
[picture p6: schematic DeltaX_SAGA.kicad_sch]

Parts:
C1, C3, C4, C24, C26: 100nF; C_0603_1608Metric
C2, C5, C15, C16, C18, C19: 0.1uF; C_0603_1608Metric
C6: 4.7uF; C_0603_1608Metric
C7, C9, C11: 1uF; C_0603_1608Metric
C8: 10nF; C_0603_1608Metric
C10, C14, C17, C20, C21, C22, C23, C29, C30, C31, C32, C33, C34, C35, C36, C37, C38: 10uF; C_0805_2012Metric
C25: 33nF; C_0603_1608Metric
C27: 100uF; C_1206_3216Metric
D1: LED; LED_0603_1608Metric
FB1: 120R; L_0603_1608Metric
J1: USB_B_Micro; FCI_10118193-0001LF
J2: Programmer; SAMTEC_FTSH-105-XX-X-DV
J3: SERVO; PinHeader_1x03_P2.54mm_Vertical
J4: M11; 1PinSMD
J5: BAT+; 1PinSMD
J6: Thrower; TE_7-215079-4
J7: BAT-; 1PinSMD
J8: M1_Encoder; TE_7-215079-4
J9: M2_Encoder; TE_7-215079-4
J10: M3_Encoder; TE_7-215079-4
J11: M12; 1PinSMD
J12: M21; 1PinSMD
J13: M22; 1PinSMD
J14: M31; 1PinSMD
J15: M33; 1PinSMD
J16: THRWR+; 1PinSMD
J17: THRWR-; 1PinSMD
L1: 5.6uH; SRP6060FA5R6M
Q1: BUK6Y10; TO127P600X120-5N
R1: 52k3; R_0603_1608Metric
R2: 10k; R_0603_1608Metric
R3: 100; R_0603_1608Metric
R4: 1k5; R_0603_1608Metric
R10, R11, R12: 3k; R_0603_1608Metric
U1: CM1223; SOT95P280X145-5N
U2: NCP164C; SOP95P275X110-5N
U3: STM32G441KB
U5: TPS62933
U6, U7: MAX14930; MAX14930DASE+
U8: MAX12930; MAX12930EASA+
U9, U10, U11: DRV8243

Connections:
+3.3V: C1.1, C2.2, C4.1, C6.1, C10.1, C11.1, C15.2, C16.2, D1.2 (A), FB1.2, J2.1, J8.2, J9.2, J10.2, U2.5 (OUT), U3.1 (VDD), U3.17 (VDD), U6.1 (VDDA), U7.1 (VDDA), U8.1 (VDDA)
+5V: C7.1, J1.1 (VBUS), U1.5 (Vp), U2.1 (IN), U2.3 (EN)
+5VD: C5.1, C18.2, C19.2, C27.2, J3.2, L1.2, R1.1, U6.16 (VDDB), U7.16 (VDDB), U8.8 (VDDB)
/3.3VA: C8.1, C9.1, FB1.1, U3.15 (VDDA)
/FB: R1.2, R2.2, U5.8 (FB)
/Motor1_DIR: U3.30 (PB7), U7.6 (INA4)
/Motor1_DIR_Isolated: U7.11 (INB4), U10.10 (PH/IN2)
/Motor1_ENCA: J8.3, U3.5 (PA0)
/Motor1_ENCB: J8.4, U3.6 (PA1)
/Motor1_OUT1: J4.1, U10.7 (OUT1)
/Motor1_OUT2: J11.1, U10.5 (OUT2)
/Motor1_PWM: U3.31 (PB8-BOOT0), U7.5 (INA3)
/Motor1_PWM_Isolated: U7.12 (INB3), U10.9 (EN/IN1)
/Motor2_DIR: U3.28 (PB5), U6.4 (INA2)
/Motor2_DIR_Isolated: U6.13 (INB2), U9.10 (PH/IN2)
/Motor2_ENCA: J10.3, U3.11 (PA6)
/Motor2_ENCB: J10.4, U3.9 (PA4)
/Motor2_OUT1: J12.1, U9.7 (OUT1)
/Motor2_OUT2: J13.1, U9.5 (OUT2)
/Motor2_PWM: U3.29 (PB6), U6.3 (INA1)
/Motor2_PWM_Isolated: U6.14 (INB1), U9.9 (EN/IN1)
/Motor3_DIR: U3.26 (PB3), U6.6 (INA4)
/Motor3_DIR_Isolated: U6.11 (INB4), U11.10 (PH/IN2)
/Motor3_ENCA: J9.3, U3.18 (PA8)
/Motor3_ENCB: J9.4, U3.19 (PA9)
/Motor3_OUT1: J14.1, U11.7 (OUT1)
/Motor3_OUT2: J15.1, U11.5 (OUT2)
/Motor3_PWM: U3.27 (PB4), U6.5 (INA3)
/Motor3_PWM_Isolated: U6.12 (INB3), U11.9 (EN/IN1)
/NRST: C3.1, J2.10, U3.4 (PG10-NRST)
/SW: C26.2, L1.1, U5.5 (SW)
/SWCLK: J2.4, U3.24 (PA14)
/SWDIO: J2.2, U3.23 (PA13)
/Servo_PWM: U3.25 (PA15), U7.3 (INA1)
/Servo_PWM_Isolated: J3.1, U7.14 (INB1)
/Thrower_PWM: U3.7 (PA2), U8.2 (IN1)
/Thrower_PWM_Isolated: J6.2, U8.7 (OUT1)
/USB_D+: J1.3 (D+), U1.3 (CH1), U3.22 (PA12)
/USB_D-: J1.2 (D-), U1.4 (CH2), U3.21 (PA11)
/V+: J5.1, J16.1, Q1.5 (D)
/VM: C14.1, C17.1, C20.1, C21.1, C22.1, C23.1, C24.1, C29.1, C30.1, C31.1, C32.1, C33.1, C34.1, C35.1, C36.1, C37.1, C38.1, Q1.1 (S), Q1.2, Q1.3, U5.3 (VIN), U9.4 (VM), U10.4 (VM), U11.4 (VM)
/nSLEEP: U3.20 (PA10), U7.4 (INA2)
/nSLEEP_Isolated: U7.13 (INB2), U9.3 (nSLEEP), U10.3 (nSLEEP), U11.3 (nSLEEP)
GND: C1.2, C2.1, C3.2, C4.2, C6.2, C7.2, C8.2, C9.2, C10.2, C11.2, C15.1, C16.1, J1.5 (GND), J2.3, J2.5, J2.9, J8.1, J9.1, J10.1, R4.2, U1.2 (Vn), U2.2 (GND), U3.14 (VSSA), U3.16 (VSS), U3.32 (VSS), U6.8 (GNDA), U7.8 (GNDA), U8.4 (GNDA)
GND2: C5.2, C14.2, C17.2, C18.1, C19.1, C20.2, C21.2, C22.2, C23.2, C24.2, C25.2, C27.1, C29.2, C30.2, C31.2, C32.2, C33.2, C34.2, C35.2, C36.2, C37.2, C38.2, J3.3, J6.1, J7.1, J17.1, R2.1, R3.2, R10.1, R11.1, R12.1, U5.4 (GND), U6.9 (GNDB), U7.9 (GNDB), U8.5 (GNDB), U9.6 (GND), U9.8 (DRVOFF), U9.11 (DIAG), U9.14 (MODE), U10.6 (GND), U10.8 (DRVOFF), U10.11 (DIAG), U10.14 (MODE), U11.6 (GND), U11.8 (DRVOFF), U11.11 (DIAG), U11.14 (MODE)
unnamed: C25.1, U5.7 (SS)
unnamed: C26.1, U5.6 (BST)
unnamed: D1.1 (K), R4.1
unnamed: Q1.4 (G), R3.1
unnamed: R10.2, U9.2 (IPROPI)
unnamed: R11.2, U10.2 (IPROPI)
unnamed: R12.2, U11.2 (IPROPI)

Notes on the sheet:
Power Decoupling
Isolators
USB and Regulator
Motor Driver
Servo
Motor Encoder Connectors
Reverse Voltage Protection
uC Reset
Battery Connector
Battery Voltage to 5V Switching Regulator
R1&R2 < 500k
Motor Ouput Connectors
V_out = V_adj*(1+R1/R2)
Thrower Motor
Programmer Connector

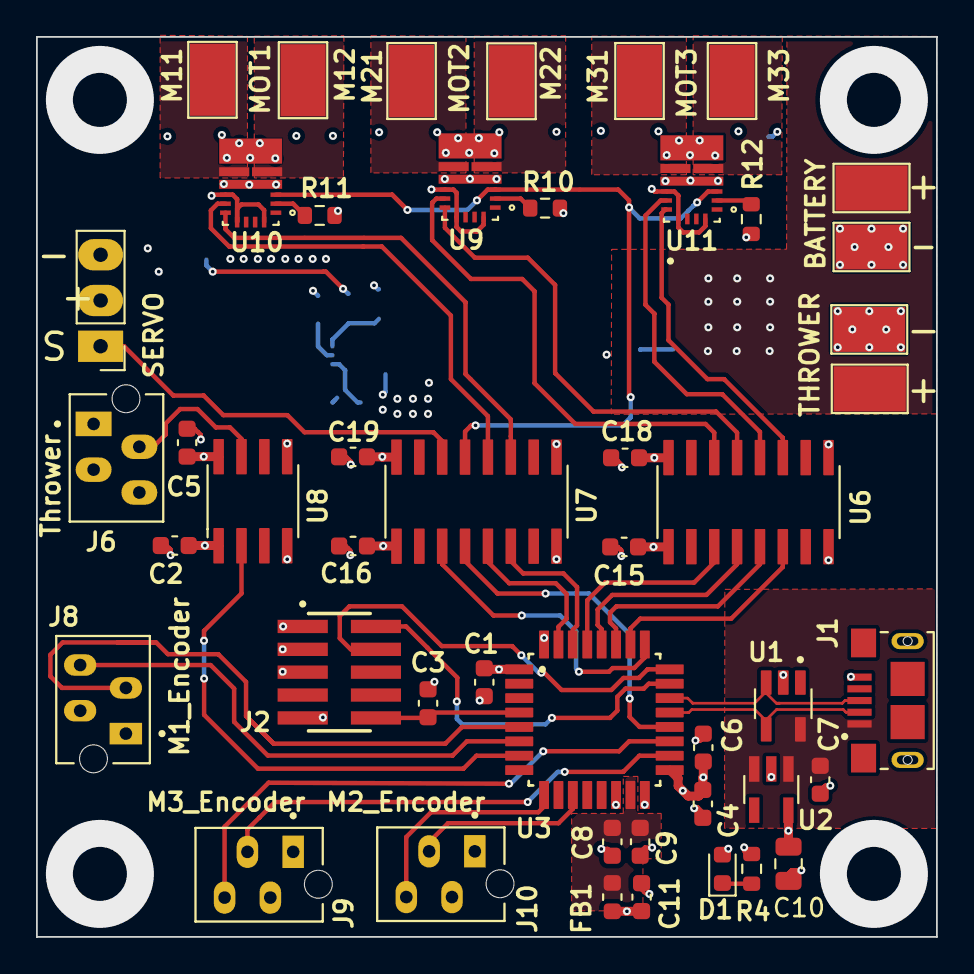
[picture p7: board DeltaX_SAGA.kicad_pcb from above]

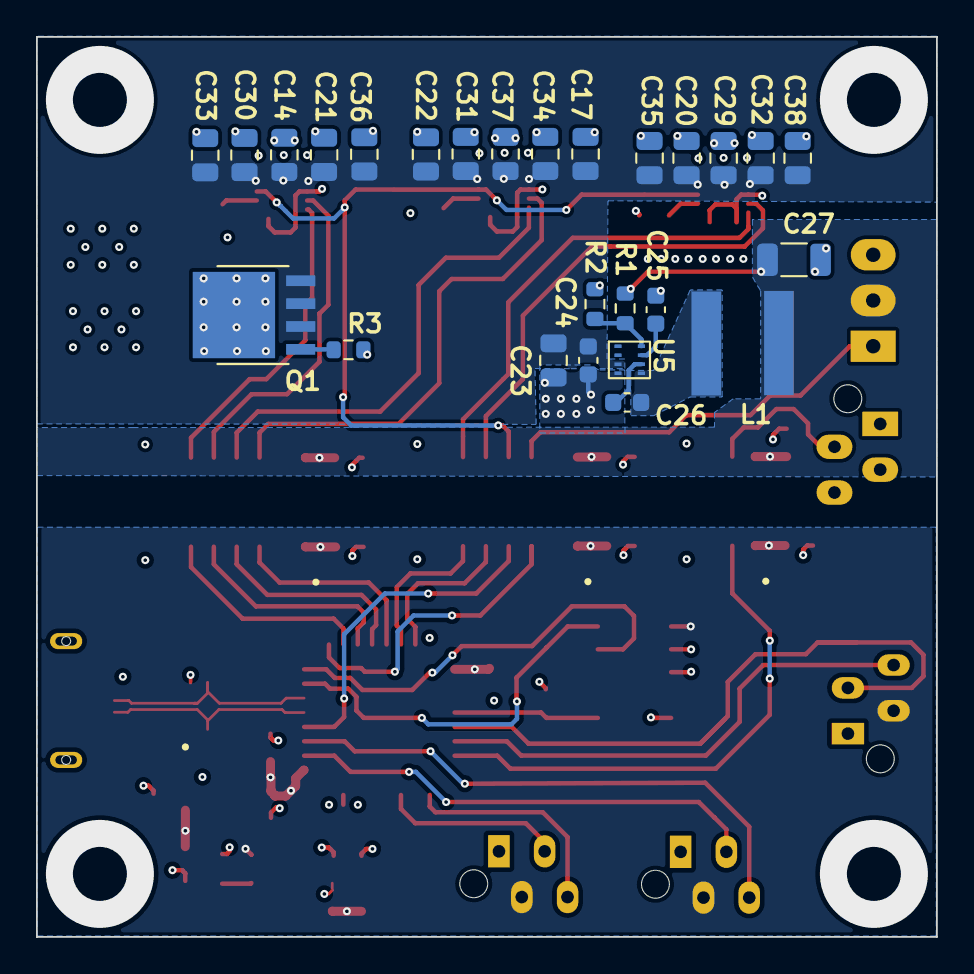
[picture p8: board DeltaX_SAGA.kicad_pcb from below]

Board: 4 copper layers, 50.0 x 50.0 mm, 73 parts (30 on the bottom side), 52 nets.
