ut-robotics/picr22-team-saga/(commit log)

2022-09-11 initial schematic design(without thrower)
    [DeltaX_SAGA.kicad_pcb, DeltaX_SAGA.kicad_sch]
2022-09-11 screenshot of the schematic design till date
2022-09-11 initial schematic updated
    [DeltaX_SAGA.kicad_sch]
2022-09-11 screenshot of updated schematic added
2022-09-11 backups for schematic added
2022-09-15 schematic updated
    [DeltaX_SAGA.kicad_sch]
2022-09-15 schematic annotated and some components assigned
    [DeltaX_SAGA.kicad_sch]
2022-09-15 renamed the schematic library directory
2022-09-15 Footprint libaries directory created with necessary footprints
2022-09-15 motor driver footprint added
2022-09-18 updated the boardc schematic and pcb design
    [DeltaX_SAGA.kicad_pcb, DeltaX_SAGA.kicad_sch]
2022-09-29 Schematic board updated
    [DeltaX_SAGA.kicad_sch]
2022-09-29 PCB design updated
    [DeltaX_SAGA.kicad_pcb]
2022-09-29 PCB dsign updated
    [DeltaX_SAGA.kicad_pcb]
2022-09-29 PCB design updated with fill zones
    [DeltaX_SAGA.kicad_pcb]
2022-09-30 Updated PCB board
    [DeltaX_SAGA.kicad_pcb, DeltaX_SAGA.kicad_sch]
2022-09-30 PCB updated
    [DeltaX_SAGA.kicad_pcb]
2022-10-03 Board schematic updated
    [DeltaX_SAGA.kicad_sch]
2022-10-03 added library for buck TPS62933
2022-10-03 Updated the PCB design
    [DeltaX_SAGA.kicad_pcb]
2022-10-03 Updated kicad files
2022-10-10 updated the reverse voltage MSOFET footprint library
2022-10-10 added footprint library for the inductor SRP6060FA5RM
2022-10-10 updated the kicad schematic symbol for the MSOFET
2022-10-10 Updated the schematic
    [DeltaX_SAGA.kicad_sch]
2022-10-10 Updated the KiCAD package
2022-10-10 updated the KiCAD prl file
2022-10-10 Updated the symbol for TPS62933 buck
2022-10-11 complete PCB updated
    [DeltaX_SAGA.kicad_pcb]
2022-10-11 added a single pin solderable pad
2022-10-12 PCB design updated and complete design added
    [DeltaX_SAGA.kicad_pcb]
2022-10-12 updated PCB design
    [DeltaX_SAGA.kicad_pcb]
2022-10-13 KiCAD package updated
2022-10-13 Reverse Voltage Protection MOSFET PCB footprint updated
2022-10-17 PCB board updated
    [DeltaX_SAGA.kicad_pcb]
2022-10-20 KiCAD package/s updated
2022-10-20 Footprint libraries updated
2022-10-23 Updated the PDB design
    [DeltaX_SAGA.kicad_pcb]
2022-10-23 KiCAD project files updated
2022-10-23 Full PCB design updated
    [DeltaX_SAGA.kicad_pcb]
2022-10-23 KiCAD project files added
2022-10-26 KiCAD project file updated
2022-10-27 PCB design added
    [DeltaX_SAGA.kicad_pcb]
2022-10-27 KiCAD project file/s added
2022-10-27 KiCAD files added
2022-10-27 Labels and orientations of certain components updated in schematic
    [DeltaX_SAGA.kicad_sch]
2022-10-27 PCB labels updated
    [DeltaX_SAGA.kicad_pcb]
2022-10-28 PCB design with label optimised and updated
    [DeltaX_SAGA.kicad_pcb]
2022-10-28 PCB labels and routing optimised and updated
    [DeltaX_SAGA.kicad_pcb]
2022-10-28 PCB design updated with labels aligned
    [DeltaX_SAGA.kicad_pcb]
2022-10-28 KiCAD project file updatde
2022-10-30 PCB design updated with routing improvements
    [DeltaX_SAGA.kicad_sch]
2022-10-30 PCB design updated with improved routing
    [DeltaX_SAGA.kicad_pcb]
2022-10-31 Updated PCB design with board cutouts and holes in proper grid size
    [DeltaX_SAGA.kicad_pcb]
2022-10-31 Updated PCB design with gerbers
    [DeltaX_SAGA.kicad_pcb]
2022-10-31 Gerber files added
    [DeltaX_SAGA-B_Cu.gbr, DeltaX_SAGA-B_Mask.gbr, DeltaX_SAGA-B_Paste.gbr, DeltaX_SAGA-B_Silkscreen.gbr, DeltaX_SAGA-Edge_Cuts.gbr, DeltaX_SAGA-F_Cu.gbr, DeltaX_SAGA-F_Mask.gbr, DeltaX_SAGA-F_Paste.gbr]
2022-10-31 PCB design updated with correct labels
    [DeltaX_SAGA.kicad_pcb]
2022-11-14 previously pads not connected reviewed and updated
    [DeltaX_SAGA.kicad_pcb]
2023-01-13 BOM file added
    [BOM.tsv]
2023-01-13 schematic PDF added
2023-01-13 PCB 3D views with annotations and labels added
2023-01-13 front PCB image updated
2023-01-14 PCB front and back 3D images with annotations and labels added
2023-01-14 PCB images front and back with annotations and labels
2023-01-14 removed previous BOM
    [BOM.tsv]
2023-01-14 updated the BOM
    [BOM.tsv]
2023-01-15 updated IPROPI resistor value
    [DeltaX_SAGA.kicad_sch]
2023-01-15 replacing old schematic
2023-01-15 updated pdf for schematic added
2023-01-15 removing old BOM
    [BOM.tsv]
2023-01-15 new BOM added
    [BOM.tsv]
2023-01-16 BOM file updated
    [BOM.tsv]
2023-01-17 added updated codes to BOM
    [BOM.tsv]
2023-01-18 updated valid and relevant codes as per the previous comments
    [BOM.tsv]
